dragonlock2/extraparts/README.md

# KiCad Libs

Some footprints and symbols that aren't native to KiCad (yet).

## How to Use

### Footprints

Add the path to extraparts.pretty/ to your project's Footprint Libraries.

### Symbols

Add the path to extraparts.kicad_sym to your project's Symbol Libraries.

### 3d Models

Go to Preferences > Configure Paths... and add an entry for "EXTRAPARTS3D" pointing to the full path of `extraparts3d/`.
