dragonlock2/extraparts/extraparts3d/FFC2B28-24-G.stp

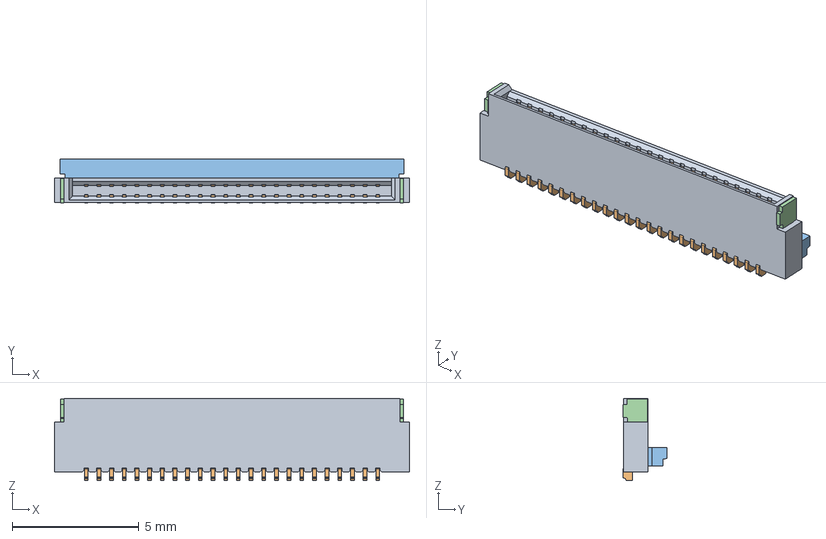
[picture p1: CAD file, 2022-02-06]
extraparts3d/FFC2B28-24-G.stp
14.0 x 1.75 x 3.25 mm
_FFC2B28-24-G_D
_FFC2B28-24-G_H
_FFC2B28-G_P x 24
_FFC2B28-24-G_C
_FFC2B28_SP x 2
