dragonlock2/extraparts/extraparts3d/CSTCR4M00G55-R0.step

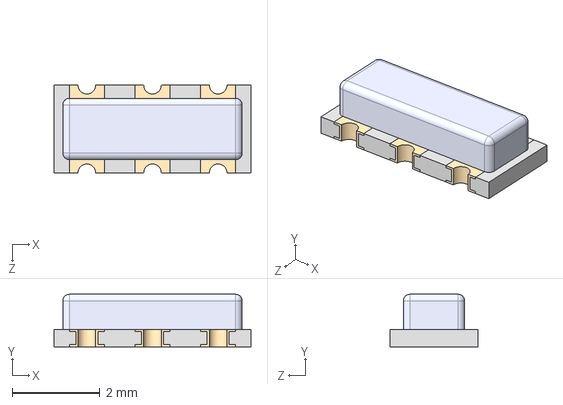
[picture p2: CAD file, 2022-02-06]
extraparts3d/CSTCR4M00G55-R0.step
4.50 x 1.20 x 2.00 mm
