dragonlock2/extraparts/extraparts3d/B6B-ZR.STEP

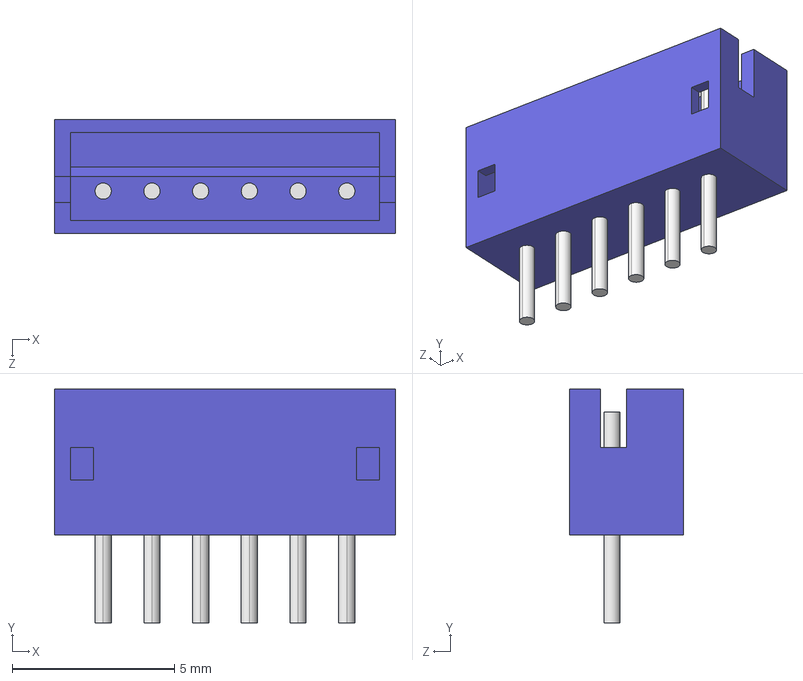
[picture p3: CAD file, 2021-06-28]
extraparts3d/B6B-ZR.STEP
10.5 x 7.20 x 3.50 mm
