dragonlock2/extraparts/extraparts3d/i6a_outline.STEP

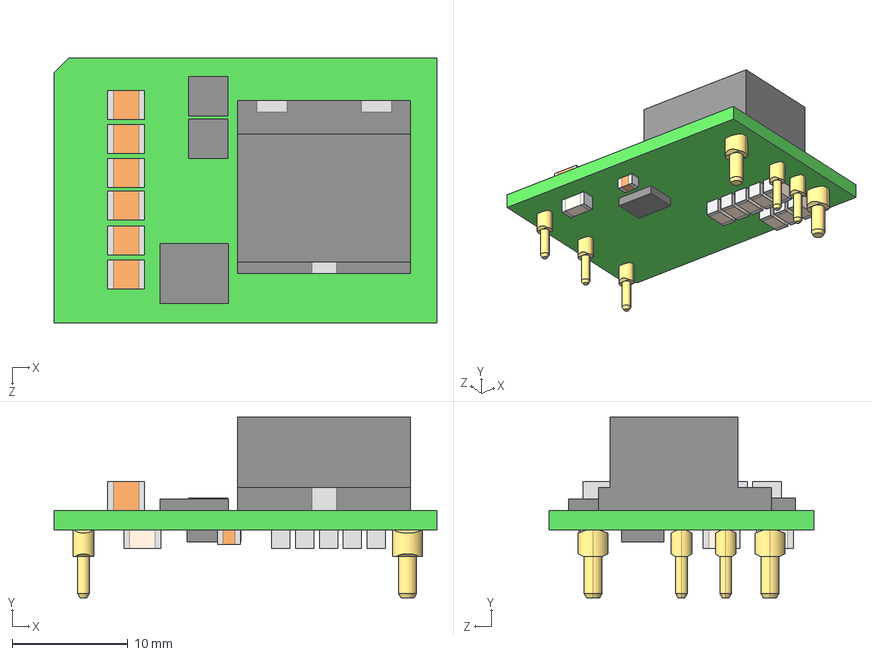
[picture p4: CAD file, 2021-02-11]
extraparts3d/i6a_outline.STEP
33.0 x 15.6 x 22.9 mm
