dragonlock2/extraparts/extraparts3d/UMPS-02-03.5-T-VT-SM-WT.stp

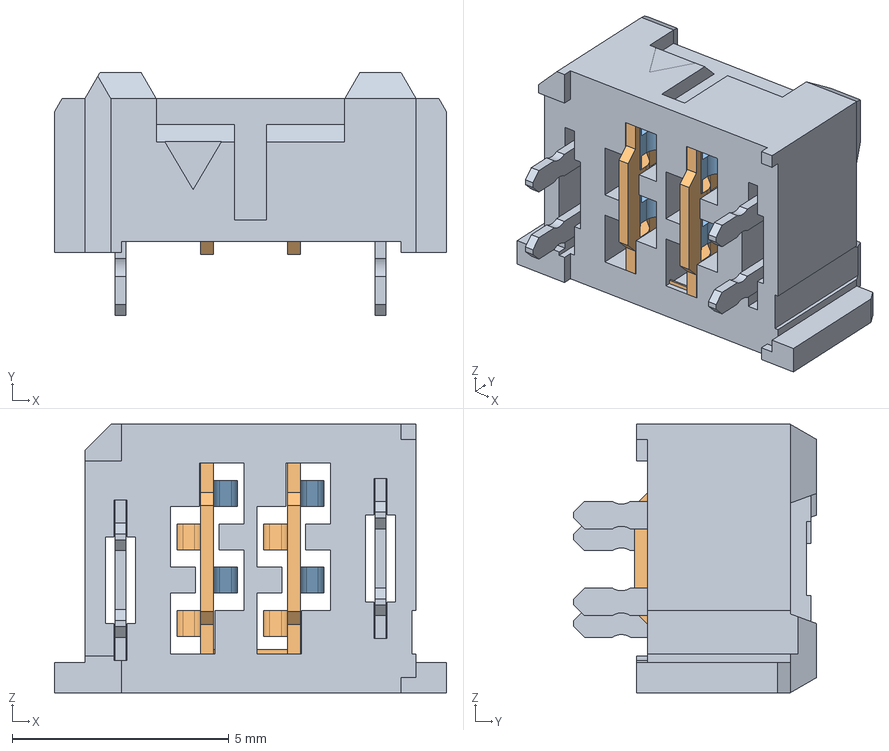
[picture p5: CAD file, 2020-12-23]
extraparts3d/UMPS-02-03.5-T-VT-SM-WT.stp
9.05 x 5.60 x 6.20 mm
_02-03.5--WT_BODY
_UMPS-02-03.5-SM_PINS
_02-03.5-SM_PINS2
