dragonlock2/extraparts/extraparts3d/UMPS-03-03.5-T-VT-SM-WT.stp

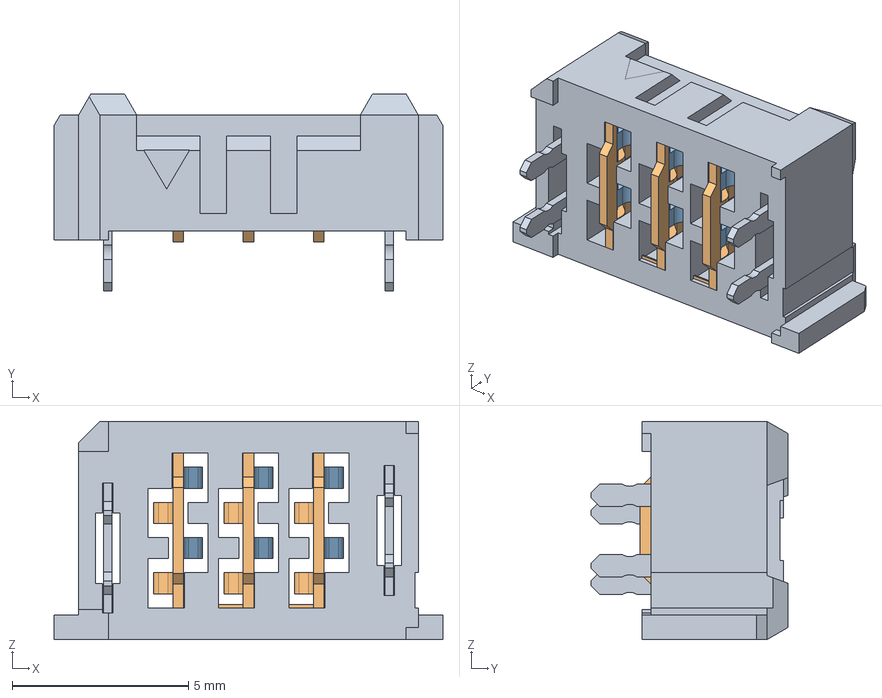
[picture p7: CAD file, 2020-12-23]
extraparts3d/UMPS-03-03.5-T-VT-SM-WT.stp
11.1 x 5.60 x 6.20 mm
_03-03.5--WT_BODY
_UMPS-03-03.5-SM_PINS
_03-03.5-SM_PINS2
