dragonlock2/extraparts/extraparts3d/UMPS-04-03.5-T-VT-SM-WT.stp

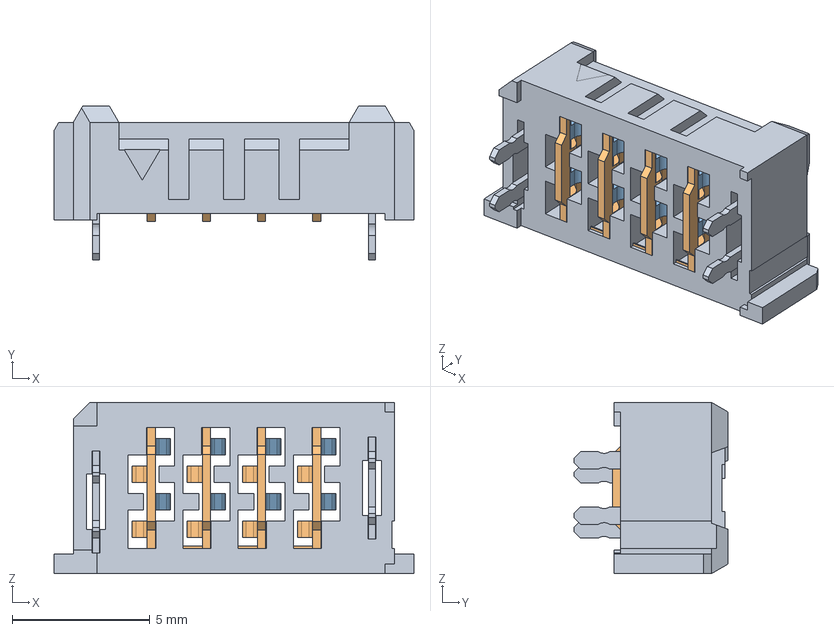
[picture p8: CAD file, 2020-12-23]
extraparts3d/UMPS-04-03.5-T-VT-SM-WT.stp
13.1 x 5.60 x 6.20 mm
_04-03.5--WT_BODY
_UMPS-04-03.5-SM_PINS
_04-03.5-SM_PINS2
