dragonlock2/extraparts/extraparts3d/UMPT-05-01.5-T-VT-SM-WT.stp

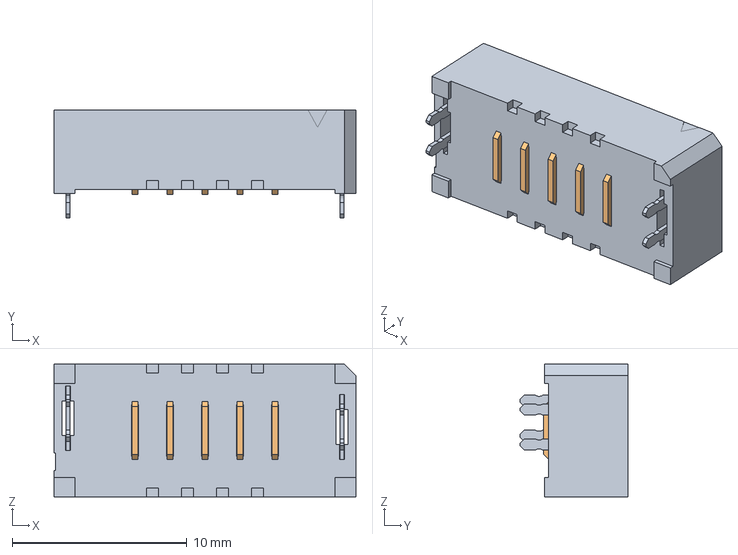
[picture p9: CAD file, 2020-12-23]
extraparts3d/UMPT-05-01.5-T-VT-SM-WT.stp
17.3 x 6.20 x 7.60 mm
_05-01.5--WT_BODY
_UMPT-05-01.5-SM-_PINS
