dragonlock2/extraparts/extraparts3d/UMPT-04-01.5-T-VT-SM-WT.stp

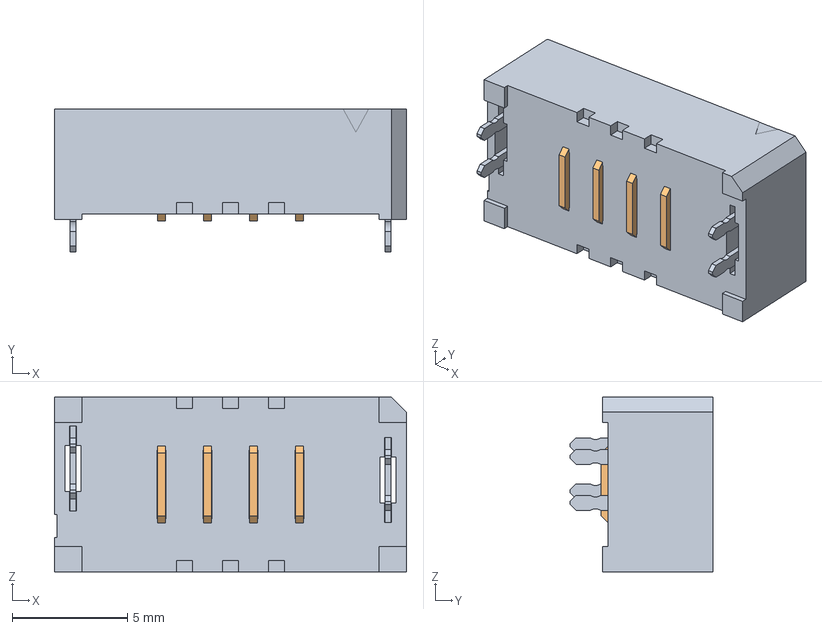
[picture p10: CAD file, 2020-12-23]
extraparts3d/UMPT-04-01.5-T-VT-SM-WT.stp
15.3 x 6.20 x 7.60 mm
_04-01.5--WT_BODY
_UMPT-04-01.5-SM-_PINS
