dragonlock2/extraparts/extraparts3d/UMPT-03-01.5-T-VT-SM-WT.stp

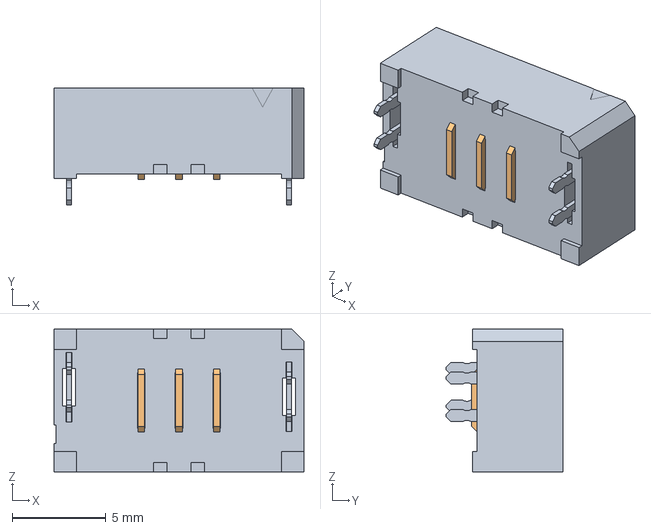
[picture p11: CAD file, 2020-12-23]
extraparts3d/UMPT-03-01.5-T-VT-SM-WT.stp
13.3 x 6.20 x 7.60 mm
_03-01.5--WT_BODY
_UMPT-03-01.5-SM-_PINS
