dragonlock2/extraparts/extraparts3d/UMPT-02-01.5-T-VT-SM-WT.stp

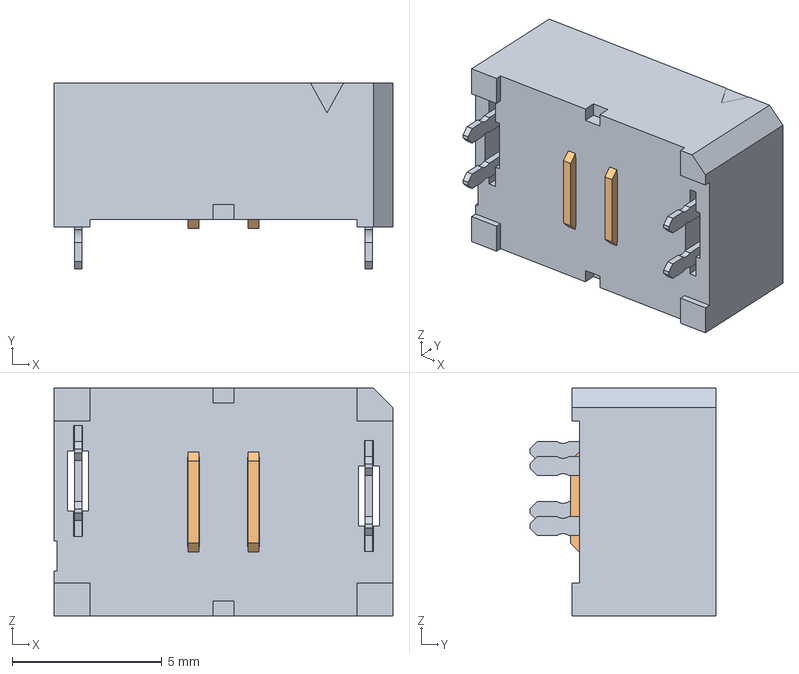
[picture p12: CAD file, 2020-12-23]
extraparts3d/UMPT-02-01.5-T-VT-SM-WT.stp
11.3 x 6.20 x 7.60 mm
_02-01.5--WT_BODY
_UMPT-02-01.5-SM-_PINS
