dragonlock2/extraparts/extraparts3d/CUI_DEVICES_SJ1-3525N.step

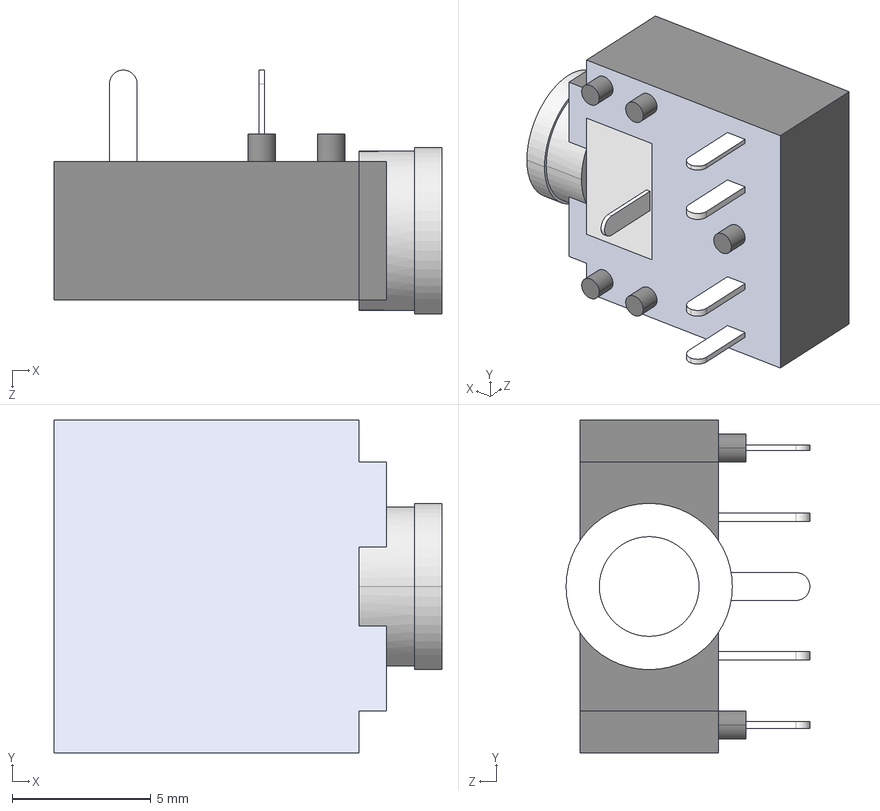
[picture p13: CAD file, 2020-12-19]
extraparts3d/CUI_DEVICES_SJ1-3525N.step
14.0 x 12.0 x 8.80 mm
