dragonlock2/extraparts/extraparts3d/1722861103.stp

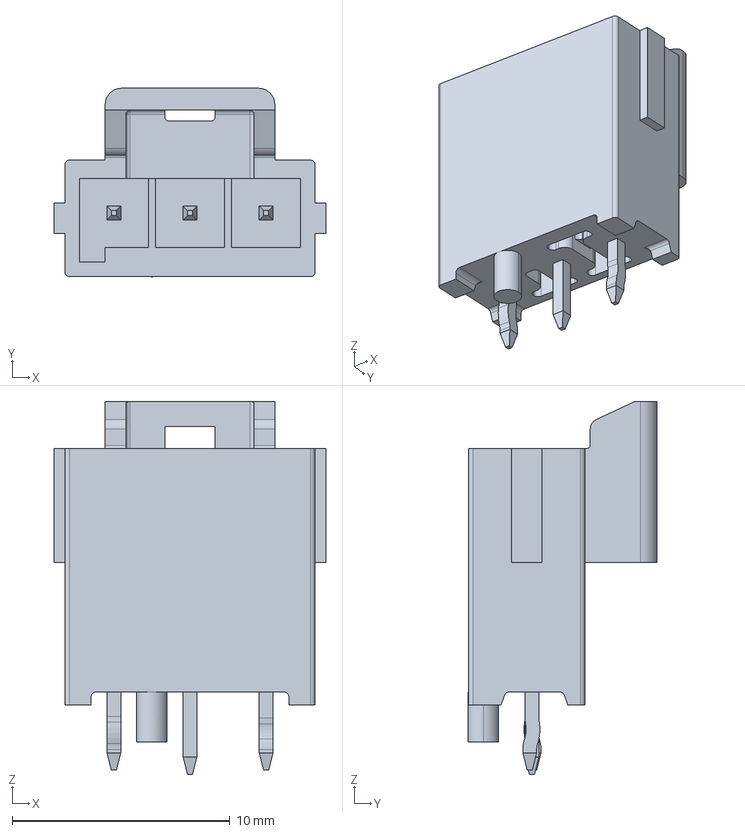
[picture p14: CAD file, 2022-03-11]
extraparts3d/1722861103.stp
12.5 x 8.67 x 17.1 mm
