dragonlock2/extraparts/extraparts3d/2157601003.stp

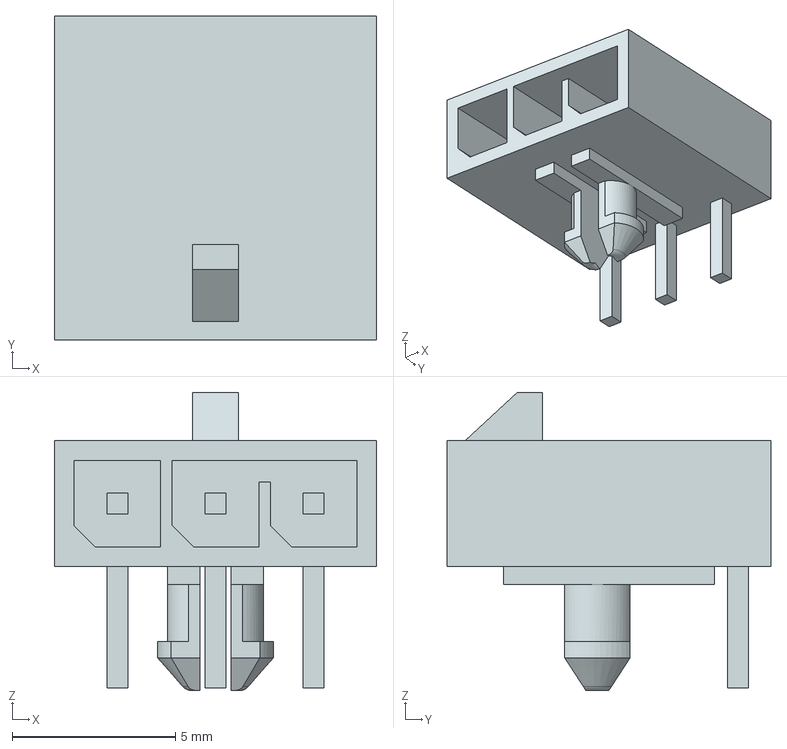
[picture p15: CAD file, 2022-01-01]
extraparts3d/2157601003.stp
9.85 x 9.91 x 9.12 mm
