dragonlock2/extraparts/extraparts3d/2157601002.stp

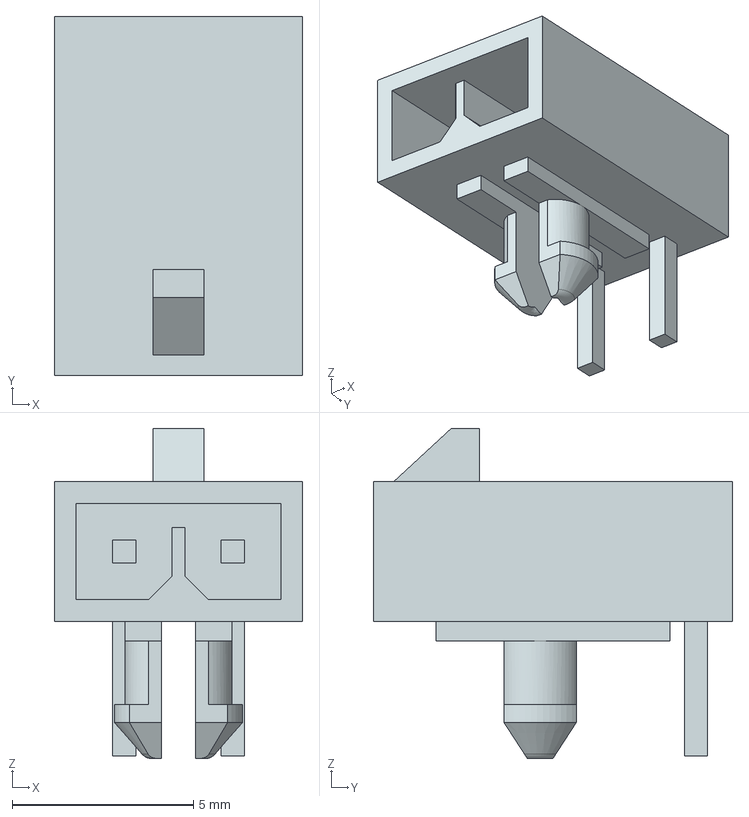
[picture p16: CAD file, 2022-01-01]
extraparts3d/2157601002.stp
6.85 x 9.91 x 9.12 mm
