dragonlock2/extraparts/extraparts3d/705530002.stp

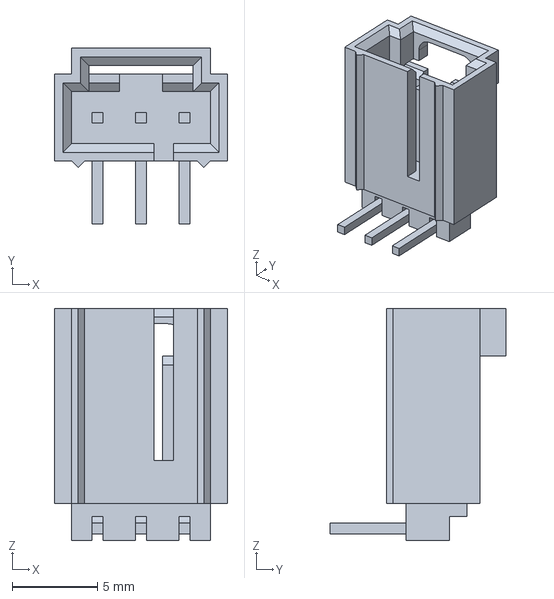
[picture p17: CAD file, 2021-12-29]
extraparts3d/705530002.stp
10.2 x 10.3 x 13.6 mm
