dragonlock2/extraparts/extraparts3d/705530001.stp

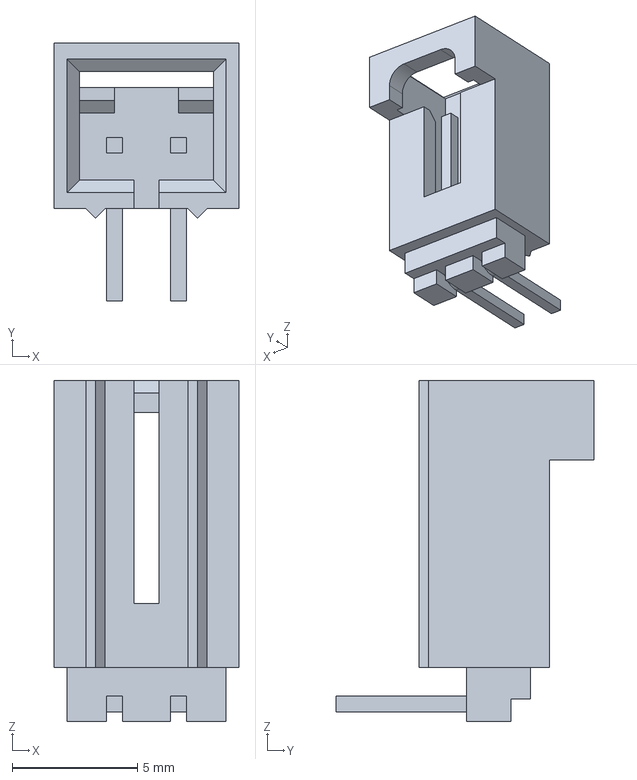
[picture p18: CAD file, 2021-12-29]
extraparts3d/705530001.stp
7.37 x 10.3 x 13.6 mm
