dragonlock2/extraparts/(list of files, cad)

Other CAD files:
extraparts3d/1720420206.stp
extraparts3d/1723101103.stp
extraparts3d/5023520210.stp
extraparts3d/5023520310.stp
extraparts3d/5023520410.stp
extraparts3d/5023520510.stp
extraparts3d/5600200230.stp
extraparts3d/5600200330.stp
extraparts3d/5600200430.stp
extraparts3d/5600200530.stp
extraparts3d/705530003.stp
extraparts3d/705530004.stp
