dragonlock2/extraparts/(commit log)

2020-11-01 Added default footprint to ATA6561
2020-11-01 Added 3D models for DuraClik
    [5600200330.stp, 5600200430.stp, 5600200530.stp]
2020-11-02 Added DuraClik RH and INA2181
    [5023520310.stp, 5023520410.stp, 5023520510.stp]
2020-11-02 Added DuraClik 2pin
    [5023520210.stp, 5600200230.stp]
2020-11-25 Added STLINK-V3MODS pure PCB footprint
2020-11-25 Updated STLINK-V3MODS schematic symbol
2020-12-19 Added microusb, 3.5mm, ncp2820
    [CUI_DEVICES_SJ1-3525N.step]
2020-12-23 Added Samtec UMPT
    [UMPT-02-01.5-T-VT-SM-WT.stp, UMPT-03-01.5-T-VT-SM-WT.stp, UMPT-04-01.5-T-VT-SM-WT.stp, UMPT-05-01.5-T-VT-SM-WT.stp]
2020-12-23 Added Samtec UMPS
    [UMPS-02-03.5-T-VT-SM-WT.stp, UMPS-03-03.5-T-VT-SM-WT.stp, UMPS-04-03.5-T-VT-SM-WT.stp, UMPS-05-03.5-T-VT-SM-WT.stp]
2021-02-11 Added I6A4W020A033V-001-R
    [i6a_outline.STEP]
2021-02-12 Added Molex Ultra-Fit RH 3pin
    [1723101103.stp]
2021-06-05 Added Molex Super Sabre 2pin vertical
    [1720420206.stp]
2021-06-27 Added Pi Pico
2021-06-28 Added JST ZH 6 pin
    [B6B-ZR.STEP]
2021-10-11 Added Keystone 9V and RH LED 3mm
2021-10-12 added rpi pico no tht
2021-10-12 added swapped led smd mount
2021-11-14 added STM32G0B1KxTxN
2021-12-03 Added THT RH LEDs
2021-12-03 shrink annular ring on LEDs
2021-12-03 shrink courtyard for LEDs
2021-12-29 added Molex SL RH
    [705530001.stp, 705530002.stp, 705530003.stp, 705530004.stp]
2021-12-29 migrate to KiCad 6
2022-01-01 update symbol footprint
2022-01-01 added molex microfit+ 2pin 3pin
    [2157601002.stp, 2157601003.stp]
2022-01-08 update to kicad 6 3d
2022-02-06 added Murata CSTCR
    [CSTCR4M00G55-R0.step]
2022-02-06 fix TPS65133 silkscreen
2022-02-06 added GST FFC2B28-24-G
    [FFC2B28-24-G.stp]
2022-03-11 added Molex Ultra-Fit 3pin vertical
    [1722861103.stp]
2022-09-02 added TC2050 + 1.27mm header combo footprint
2022-09-07 added barrel_3.5mm footprint
2022-09-30 added NXP_XSON-8 footprint
2023-03-04 added Pi Pico W footprint
2023-12-09 add USB-307HI footprint
2024-03-12 update kicad 8.0.0
2024-07-15 add DLW43SH101 footprint, modernize others
2024-07-19 add DLW32SH101 footprint
