dragonlock2/extraparts/(notices)

Notices in the files:
extraparts3d/UMPT-03-01.5-T-VT-SM-WT.stp:
FILE_NAME( 'p:/temp/worker_3/temp/exporttempdir_4028_113_79nYI/format_0/UMPT-03-01.5-T-VT-SM-WT.stp', '2020-12-23T10:37:09', ( 'License CC BY-ND 4.0' ), ( 'CADENAS' ), ' ', 'PARTsolutions', ' ' );
extraparts3d/FFC2B28-24-G.stp:
FILE_NAME( 'p:/temp/worker_27/temp/exporttempdir_5448_622_c52T9/format_0/FFC2B28-24-G.stp', '2022-02-06T23:47:39', ( 'License CC BY-ND 4.0' ), ( 'CADENAS' ), ' ', 'PARTsolutions', ' ' );
extraparts3d/UMPT-04-01.5-T-VT-SM-WT.stp:
FILE_NAME( 'p:/temp/worker_452/temp/exporttempdir_1412_30_lTAI5/format_0/UMPT-04-01.5-T-VT-SM-WT.stp', '2020-12-23T10:45:28', ( 'License CC BY-ND 4.0' ), ( 'CADENAS' ), ' ', 'PARTsolutions', ' ' );
extraparts3d/UMPS-05-03.5-T-VT-SM-WT.stp:
FILE_NAME( 'p:/temp/worker_9/temp/exporttempdir_1748_93_We4Nz/format_0/UMPS-05-03.5-T-VT-SM-WT.stp', '2020-12-23T11:48:51', ( 'License CC BY-ND 4.0' ), ( 'CADENAS' ), ' ', 'PARTsolutions', ' ' );
extraparts3d/UMPT-05-01.5-T-VT-SM-WT.stp:
FILE_NAME( 'p:/temp/worker_5/temp/exporttempdir_4428_96_gUusm/format_0/UMPT-05-01.5-T-VT-SM-WT.stp', '2020-12-23T10:48:51', ( 'License CC BY-ND 4.0' ), ( 'CADENAS' ), ' ', 'PARTsolutions', ' ' );
extraparts3d/UMPT-02-01.5-T-VT-SM-WT.stp:
FILE_NAME( 'p:/temp/worker_448/temp/exporttempdir_3804_293_5sagp/format_0/UMPT-02-01.5-T-VT-SM-WT.stp', '2020-12-23T10:12:47', ( 'License CC BY-ND 4.0' ), ( 'CADENAS' ), ' ', 'PARTsolutions', ' ' );
extraparts3d/UMPS-04-03.5-T-VT-SM-WT.stp:
FILE_NAME( 'p:/temp/worker_775/temp/exporttempdir_5696_233_AhXkw/format_0/UMPS-04-03.5-T-VT-SM-WT.stp', '2020-12-23T11:45:06', ( 'License CC BY-ND 4.0' ), ( 'CADENAS' ), ' ', 'PARTsolutions', ' ' );
extraparts3d/UMPS-03-03.5-T-VT-SM-WT.stp:
FILE_NAME( 'p:/temp/worker_773/temp/exporttempdir_4760_79_aJtw6/format_0/UMPS-03-03.5-T-VT-SM-WT.stp', '2020-12-23T11:37:19', ( 'License CC BY-ND 4.0' ), ( 'CADENAS' ), ' ', 'PARTsolutions', ' ' );
extraparts3d/UMPS-02-03.5-T-VT-SM-WT.stp:
FILE_NAME( 'p:/temp/worker_450/temp/exporttempdir_4088_751_t4Dnt/format_0/UMPS-02-03.5-T-VT-SM-WT.stp', '2020-12-23T11:33:48', ( 'License CC BY-ND 4.0' ), ( 'CADENAS' ), ' ', 'PARTsolutions', ' ' );
